madcatse/TZXDuino_MC/kikad/TZXDuino.kicad_pcb

## KiCad design kikad/TZXDuino.kicad_pcb (2024-04-02)

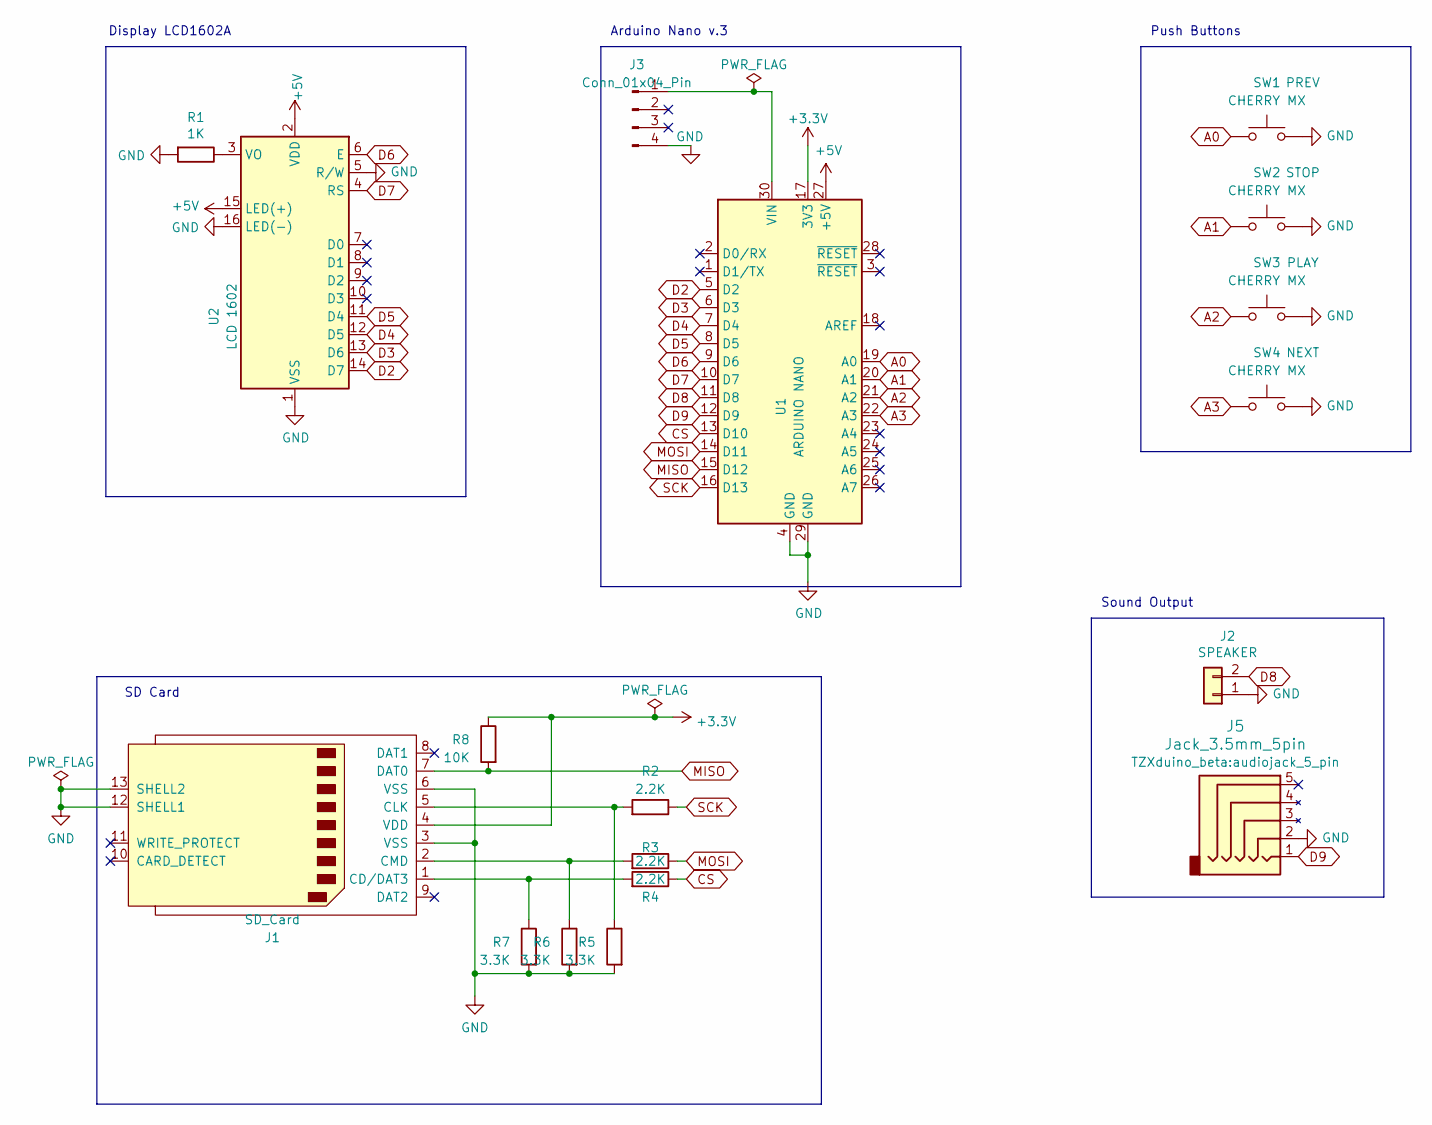
[picture p2: schematic TZXDuino.kicad_sch, TZXDuino with Human Face]

Parts:
J1: SD_Card; SDCARD_4UCONN
J2: SPEAKER; Speaker
J3: Conn_01x04_Pin; USB-C Power board
J5: Jack_3.5mm_5pin; audiojack_5_pin
R1: 1K; R_Axial_DIN0207_L6.3mm_D2.5mm_P10.16mm_Horizontal
R2, R3, R4: 2.2K; R_Axial_DIN0207_L6.3mm_D2.5mm_P10.16mm_Horizontal
R5, R6, R7: 3.3K; R_Axial_DIN0207_L6.3mm_D2.5mm_P10.16mm_Horizontal
R8: 10K; R_Axial_DIN0207_L6.3mm_D2.5mm_P10.16mm_Horizontal
SW1, SW2, SW3, SW4: CHERRY MX; SW_Cherry_MX_1.00u_PCB
U1: ARDUINO NANO; Arduino_Nano
U2: LCD 1602; LCD1602

Connections:
+3.3V: J1.4 (VDD), R8.1, U1.17 (3V3)
+5V: U1.27 (+5V), U2.2 (VDD), U2.15 (LED(+))
A0: SW1.1, U1.19 (A0)
A1: SW2.1, U1.20 (A1)
A2: SW3.1, U1.21 (A2)
A3: SW4.1, U1.22 (A3)
CS: R4.1, U1.13 (D10)
D2: U1.5 (D2), U2.14 (D7)
D3: U1.6 (D3), U2.13 (D6)
D4: U1.7 (D4), U2.12 (D5)
D5: U1.8 (D5), U2.11 (D4)
D6: U1.9 (D6), U2.6 (E)
D7: U1.10 (D7), U2.4 (RS)
D8: J2.2, U1.11 (D8)
D9: J5.1, U1.12 (D9)
GND: J1.3 (VSS), J1.6 (VSS), J1.12 (SHELL1), J1.13 (SHELL2), J2.1, J3.4, J5.2, R1.2, R5.2, R6.2, R7.2, SW1.2, SW2.2, SW3.2, SW4.2, U1.4 (GND), U1.29 (GND), U2.1 (VSS), U2.5 (R/W), U2.16 (LED(-))
MISO: J1.7 (DAT0), R8.2, U1.15 (D12)
MOSI: R3.1, U1.14 (D11)
unnamed: J1.1 (CD/DAT3), R4.2, R7.1
unnamed: J1.5 (CLK), R2.2, R5.1
unnamed: J1.2 (CMD), R3.2, R6.1
unnamed: J3.1, U1.30 (VIN)
unnamed: R1.1, U2.3 (VO)
SCK: R2.1, U1.16 (D13)

Notes on the sheet:
Push Buttons
Sound Output
Display LCD1602A
Arduino Nano v.3
SD Card

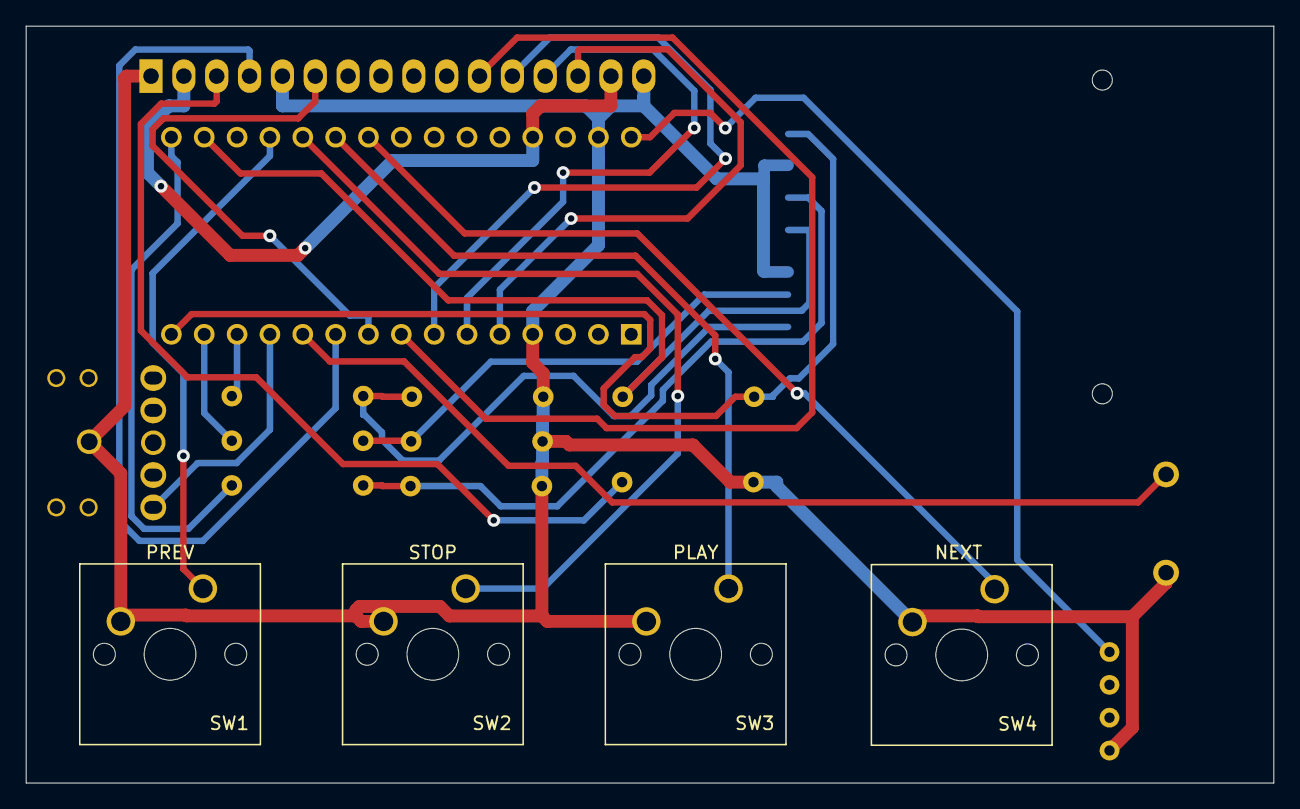
[picture p3: board TZXDuino.kicad_pcb from above]

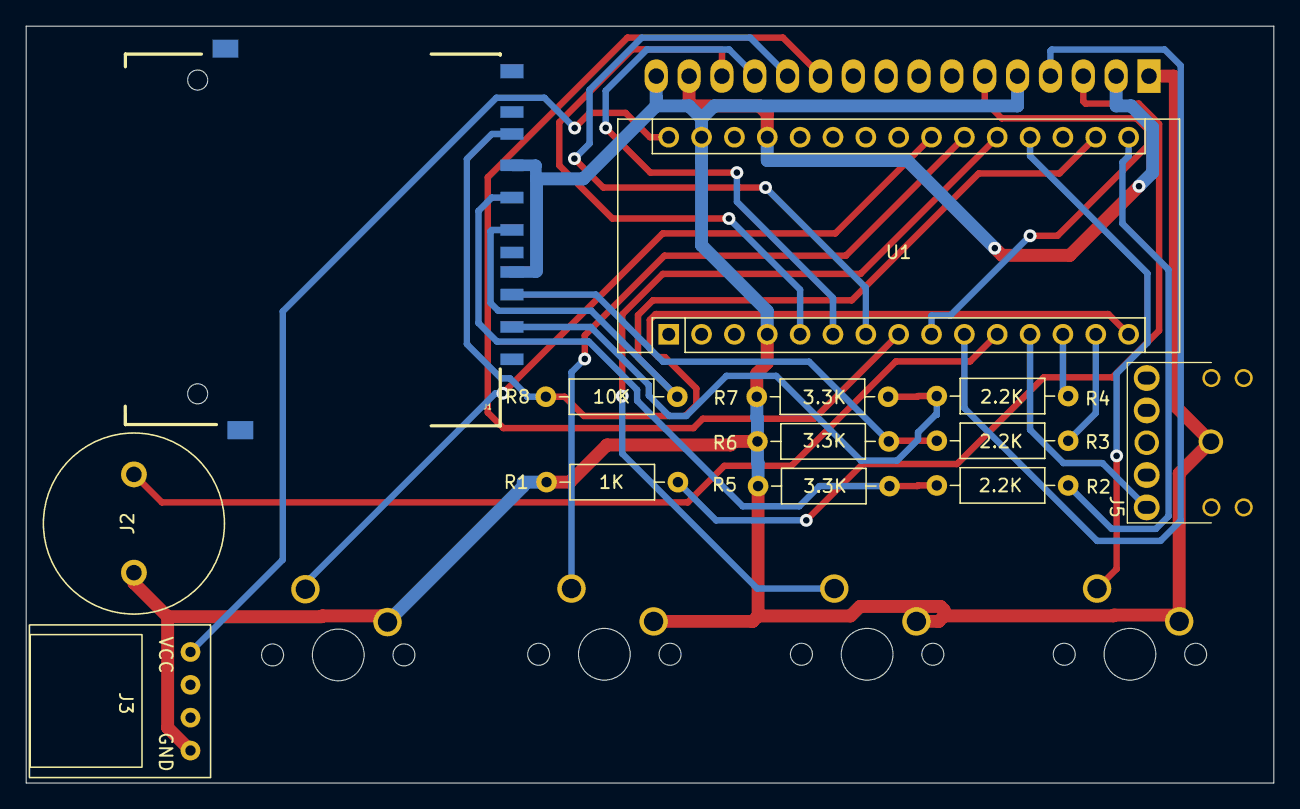
[picture p4: board TZXDuino.kicad_pcb from below]

Board: 2 copper layers, 96.5 x 58.5 mm, 18 parts (13 on the bottom side), 24 nets.
